cphoton/RUDE/docs/BOM.md

# BOM

For an upgrade from RUDE v1.0 to v1.1 the only hardware changes are the six ⌀5mm rods which have been replaced by just two 350 ⌀5mm steel rods and the 2x M5x40 steering bolts have been replaced by 2x M5x30.

If you come from Robak, you need HSP 102011 and 2x350 ⌀5mm steel rods and additional SHCS M3 + hex-nuts and 2x M5x30 bolts + square nuts.

This car can handle more power than Robak and is also heavier, I don't advise anything below 3S.
However be careful with 4S and higher since the HSP differentials were not designed with such powerful cars in mind. A precisely printed diffcase with a quality diff from the supplier I recommend below are key. Buy spares.

## Filament

98A / 60+D TPU from anywhere. Azurefilm 98A TPU is good. On Amazon there is 64D TPU from kexcelled alternatively there is 72D TPU from extrudr.
Not very useful for RUDE, but I use this super cheap quality filament for everything else (gridfinity etc.): https://s.click.aliexpress.com/e/_olmRVrv

## Electronics

Part | Name | QTY | Notes
--- | --- | --- | ---
ESC + motor | 36xx or 42xx up to 82mm length | 1 | F.e. 3660 = 36mm diameter & 60mm length, 4278 = 42mm diameter & 78mm length.
ESC + motor | Hobbywing Ezrun MAX10 3665SD G3 2400KV + G2 140A ESC | 1 | Recommended. The newest Ezrun MAX10 sensored series is great. Get your Hobbywing electronics at a local shop, because aliexpress doesn't do warranty!
Battery for 4S combo [max 139mm x 47mm] hardcase preferred | 3S/4S 6200mAh | 1 | 3S: https://s.click.aliexpress.com/e/_EJYJMRf 4S: https://s.click.aliexpress.com/e/_oDYiMl3 or 9400mAh big battery: https://s.click.aliexpress.com/e/_mN7RnQx
Lipo charger | | 1 | https://s.click.aliexpress.com/e/_oCQhBod
RX + TX | DumboRC DDF-350 | X10FG or X6DCG | screen, lights/indicators support and with gyro https://s.click.aliexpress.com/e/_oCQUDqW (select M2 for metal steering wheel)
Servo | DS3240-180 or any other 180 deg variant | 1 | https://s.click.aliexpress.com/e/_DnBFawT
1:8 Motor | Ysido 4274 | 1 | Cheap but overpowered https://s.click.aliexpress.com/e/_DmBblkx NOTE: you need a 1:8 ESC for this. [has 6.5mm banana plugs instead of 4mm]
1:8 ESC | Hobbywing Quicrun 8BL150 | 1 | I use this in combination with the Ysido. Get your Hobbywing electronics at a local shop, because aliexpress doesn't do warranty!

NOTE: 1:8 motors are at least twice as powerful as 1:10 motors and too much for RUDE which is a 1:10 truggy. One user tried the Ezrun MAX8 Sensored series and it kept somersaulting with just 4S with acceleration and throttle limited. Too much power causes the metal HSP parts to fail. I personally use the Ysido 2200 kV on 4S without issues, but make sure to limit throttle on tranmsitter and acceleration in ESC (this also goes for 1:10 MAX10).

## HSP

Part | Name | QTY | Notes
--- | --- | --- | ---
steering links | HSP 102011 | 2 | different from stock Robak
differential | HSP 02024 |2 | https://aliexpress.com/item/1178316591.html I recommend to get all your HSP parts from this store. Their quality seems to be superior. You can order, cancel payment, then ask seller to reduce the shipping costs.
front gear | HSP 02030 |1 |
rear gear | HSP 03015 |1 |e-clip shoud be included
cvd | HSP 108015 |4 |2 types available; more info on robaki.dev
5/6/7mm wheel hex | HSP 122042 |4 | https://s.click.aliexpress.com/e/_DnSrrOX depth depends a bit on the type of wheel. For the recommended wheels 5/6mm.
cups | HSP 02016 |2 |
servo link | HSP 02012 |1 |
steering links | HSP 08042 |1 |one pair (06016 also fits)
drive shaft | HSP 04003 |1 |
spur gear | HSP 11184 |1 |
pinion gear | HSP 11184 |1 | 21-29T ⌀3.175/5mm, check shaft of your motor. For weaker motors pick 21T.
ball head screw | HSP 02038 |4 |for steering
small bearings |5x10x4mm | 9pcs | https://s.click.aliexpress.com/e/_oC5hRkd / https://s.click.aliexpress.com/e/_opMIPU9 SMR105RS (ceramic!)
big bearings |10x15x4mm | 12pcs | https://s.click.aliexpress.com/e/_oFJ5Pg9

### HSP must-have spares

Part | Name | QTY | Notes
--- | --- | --- | ---
differential | HSP 02024 | 2 |
front gear | HSP 02030 |1 |
rear gear | HSP 03015 |1 |e-clip shoud be included
cups | HSP 02016 |1 |
cvd | HSP 108015 |2 |
drive shaft | HSP 04003 |1 |
pinion gear | HSP 11184 |1 |⌀3.175/5mm, check shaft of your motor
grub screws | HSP 02099 |1 |
main gear pin | HSP 08027 |1 |
small bearings |5x10x4mm | 4 | 
big bearings |10x15x4mm | 4 | 
diff cups | HSP 02032 | 4 |

## Other

Part | Name | QTY | Notes
--- | --- | --- | ---
wheels | HSP 88005 | 4 | I recommend cheap plastic rims https://aliexpress.com/item/4000537437419.html . They break but are cheap to replace. There's also metal ones https://aliexpress.com/item/4000537479774.html they don't break but will transfer impacts to CVDs which then wobble, hence I recommend the 'weak' plastic rims. The previous ones need to be glued manually. Preglued (much better) options: Traxxas wheels TRX6792. Alternatively very cheap set from YSIDO: https://s.click.aliexpress.com/e/_oF5A4wt the wheels are very narrow and the steering angle is very small, to compensate take 7mm wheel hex for front wheels ( https://s.click.aliexpress.com/e/_DnSrrOX ).
shocks |INJORA Aluminum Shock Absorber 100mm | 4 | https://s.click.aliexpress.com/e/_EQmCy8T comes with two springs per shock, use them both, intertwined
battery straps |20mm width; 200mm long |2 |max width 25mm
Steel shafts |⌀5mm steel rod | 2x350mm | https://s.click.aliexpress.com/e/_ooYsAH1 (v1.0 needed 2x190mm + 4x66mm ⌀5mm steel rods)
silicone oil (front & rear shocks) | 2000 cSt | 20ml | this car's mass is >3kg so heavier oils preferred https://s.click.aliexpress.com/e/_ooUaPnU (very cheap)
silicone oil (diffs) |80.000 cSt | 20ml |50.000-100.000 cSt will work https://s.click.aliexpress.com/e/_mKMass6 (from local shop is likely cheaper)
thread-locking fluid | | 10ml | Medium strength blue (cheap option: https://s.click.aliexpress.com/e/_mtYoqXC )
lithium grease | | 50ml |or any other grease for gears
CA glue / ZAP-RT | power glue | 20ml |tire glue (ZAP-RT for metal rims)

## Bolts

Part | Name | QTY | Notes
--- | --- | --- | ---
M5 Socket Head Screws | M5 SHCS 2x30mm | | https://s.click.aliexpress.com/e/_mNYNVTc
M5 Square Nuts  | | 2 | https://s.click.aliexpress.com/e/_mKvxiiA
M3 Socket Head Screws | M3 SHCS 4x30 4x20 4x16 4x12 1x6mm | | https://s.click.aliexpress.com/e/_mNYNVTc
M3 Titanium SHCS | DIN912 | M3 SHCS 4x30mm | https://s.click.aliexpress.com/e/_oCheVJZ for top bolts for shock mounting titanium is recommended to prevent bends
M3 Flat Head Screws | M3 FHCS 30/25/20/16/12mm |20pcs each | https://s.click.aliexpress.com/e/_ontwkaW
M3 Thin Square Nuts  |DIN 562 |50 |ht. 1.8mm https://s.click.aliexpress.com/e/_mKvxiiA
M3 Nylon-Insert Locknuts |DIN 985; ISO 10511 |12 | for arm hinges https://s.click.aliexpress.com/e/_mKRqmKW
M3 General Purpose Washers |DIN 125; ISO 7089 |3 |motor mount to the plate https://s.click.aliexpress.com/e/_ooqqPiE
M4 Nylon-Insert Locknuts |DIN 985; ISO 10511 |4 |for wheels https://s.click.aliexpress.com/e/_mKRqmKW
M4 General Purpose Washers |DIN 125; ISO 7089 |4 |for wheels https://s.click.aliexpress.com/e/_ooqqPiE

## For stock body

Part | Name | QTY | Notes
--- | --- | --- | ---
M2x10mm Socket Head Screws |DIN 912; ISO 4762 |10 |bolt 2 body parts together https://s.click.aliexpress.com/e/_mKoi8nC 
M2 Nylon-Insert Locknuts |DIN 985; ISO 10511 |10 |bolt 2 body parts together https://s.click.aliexpress.com/e/_mKRqmKW
M8x60 bolt full thread |  |1 | Full Thread! To bolt rear body part to car. https://s.click.aliexpress.com/e/_EJMfISf 
M8 flange lock nut |  |1 | https://s.click.aliexpress.com/e/_Ew4tm55
M8 wing nut |  |1 | https://s.click.aliexpress.com/e/_EwzpS4j

## Tools

Part | Name | QTY | Notes
--- | --- | --- | ---
Worx electric screwdriver | WX242 | 1 | https://aliexpress.com/item/1005006025572712.html 
Allen bits | H2 | 2 | https://s.click.aliexpress.com/e/_EuJdN3h
Lipo checker | | 1 | https://s.click.aliexpress.com/e/_opcYMvr
