cphoton/RUDE/STEP/EXPERIMENTAL/Center Diffs/diy/CenterDiffPlate.step

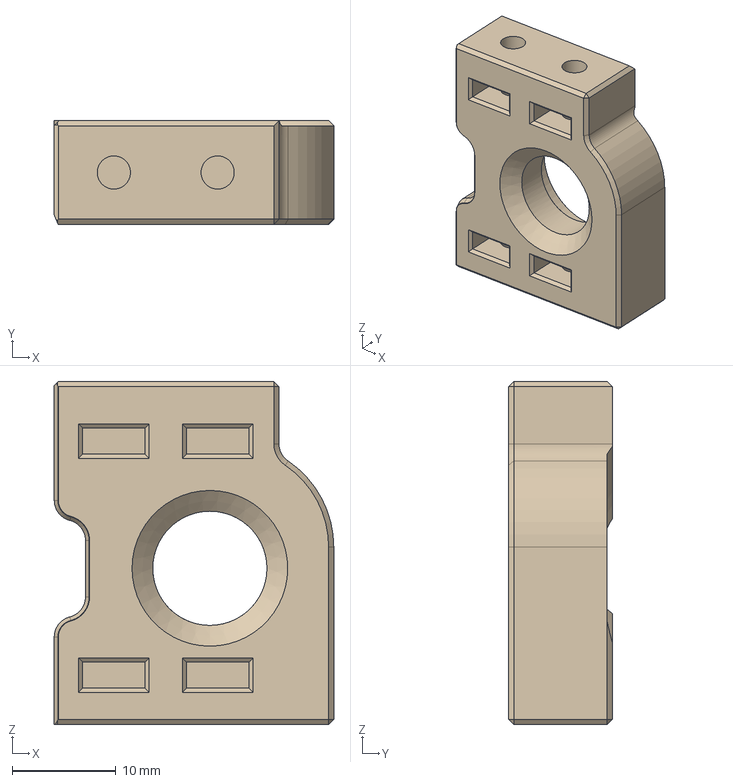
[picture p1: CAD file, 2025-06-04]
STEP/EXPERIMENTAL/Center Diffs/diy/CenterDiffPlate.step
26.9 x 10.0 x 33.1 mm
