cphoton/RUDE/STEP/EXPERIMENTAL/Center Diffs/non-diy/MotorPlate_ysido.step

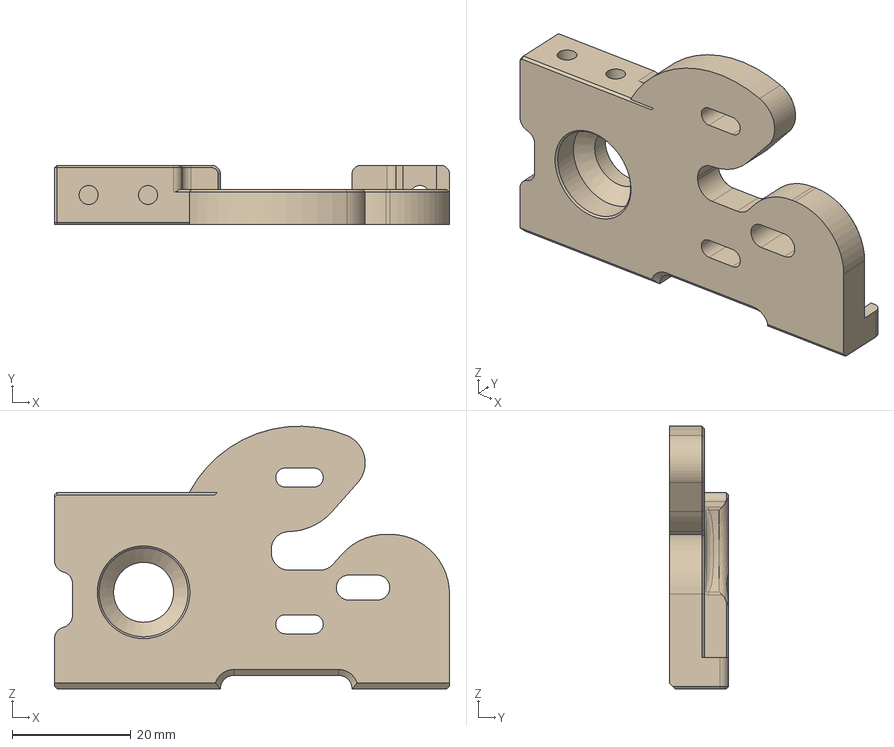
[picture p2: CAD file, 2025-06-04]
STEP/EXPERIMENTAL/Center Diffs/non-diy/MotorPlate_ysido.step
66.5 x 10.0 x 44.2 mm
