cphoton/RUDE/STEP/EXPERIMENTAL/Chassis.step

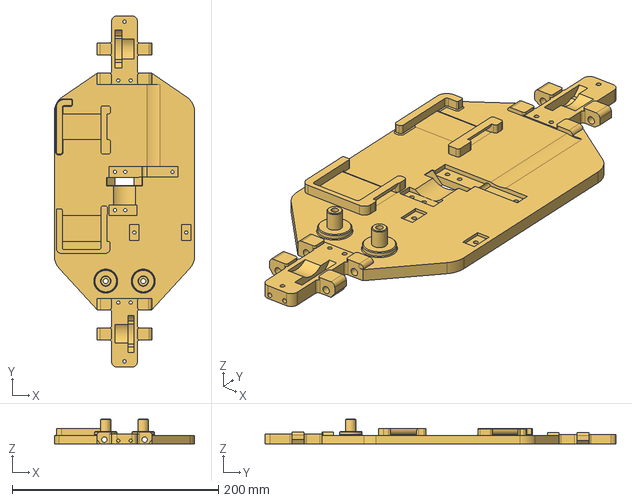
[picture p3: CAD file, 2025-06-04]
STEP/EXPERIMENTAL/Chassis.step
136.0 x 340.0 x 23.8 mm
