cphoton/RUDE/STEP/v1.1/Chassis.step

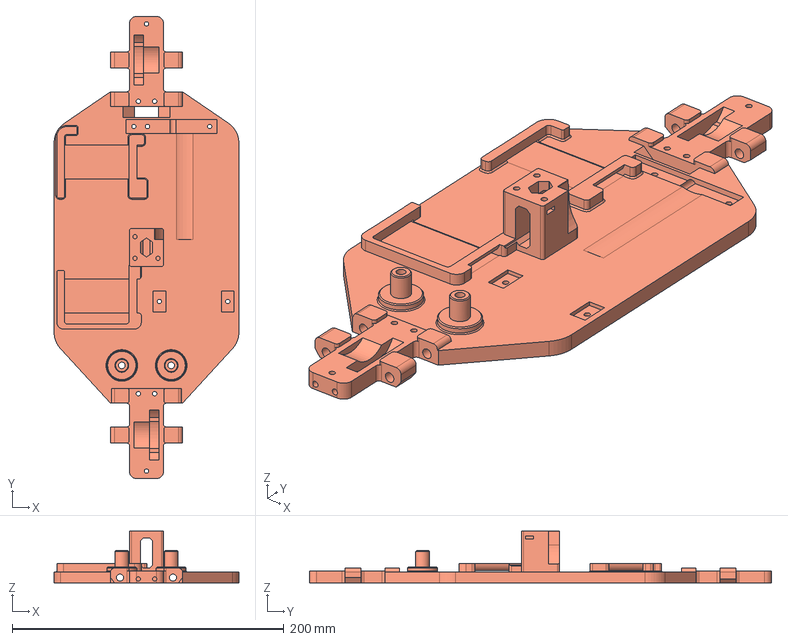
[picture p4: CAD file, 2025-08-29]
STEP/v1.1/Chassis.step
136.0 x 340.0 x 38.3 mm
