cphoton/RUDE/STEP/EXPERIMENTAL/Center Diffs/non-diy/CenterDiffPlate.step

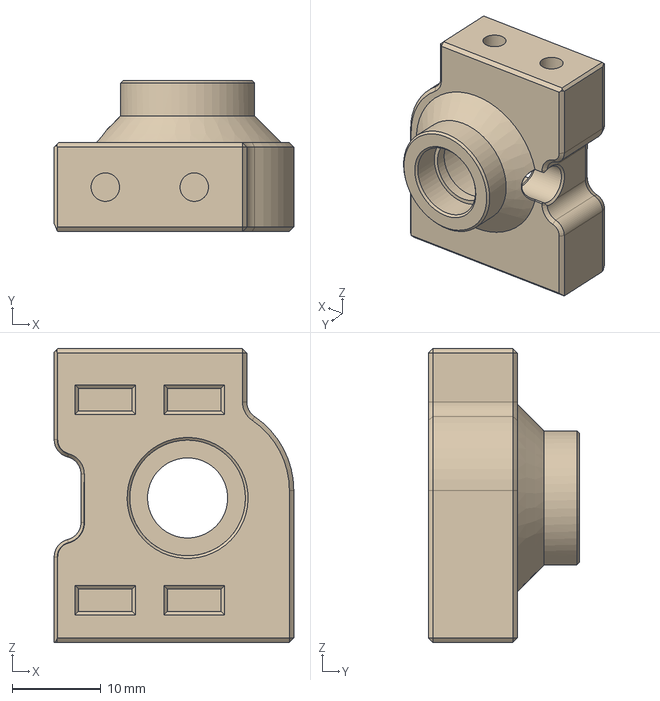
[picture p5: CAD file, 2025-06-04]
STEP/EXPERIMENTAL/Center Diffs/non-diy/CenterDiffPlate.step
26.9 x 17.0 x 33.1 mm
