cphoton/RUDE/STEP/EXPERIMENTAL/TopDeck.step

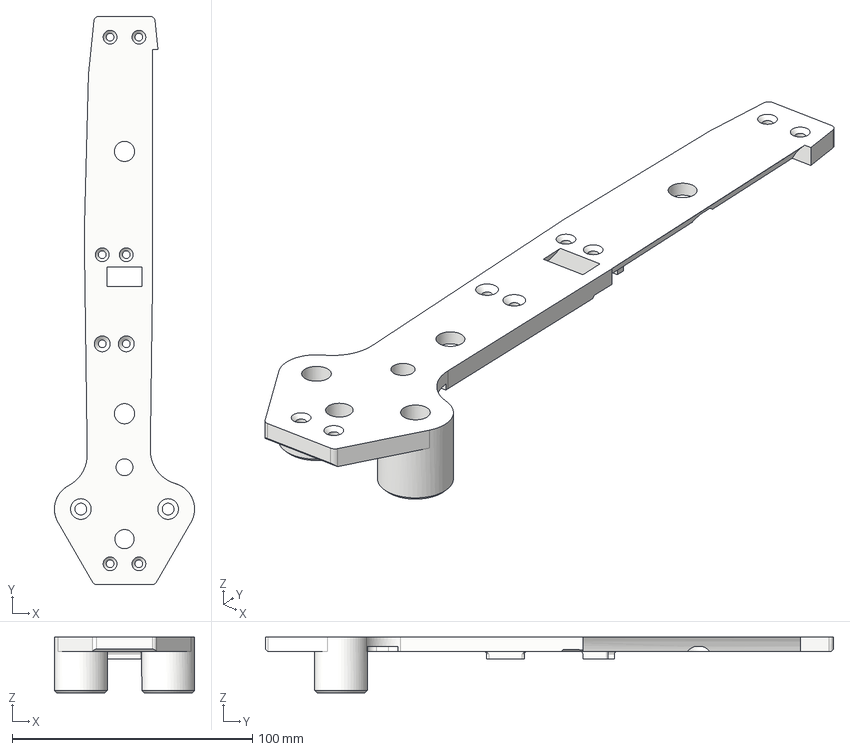
[picture p6: CAD file, 2025-06-04]
STEP/EXPERIMENTAL/TopDeck.step
58.3 x 236.4 x 23.2 mm
