cphoton/RUDE/STEP/EXPERIMENTAL/ServoMount_Quicrun8BL150.step

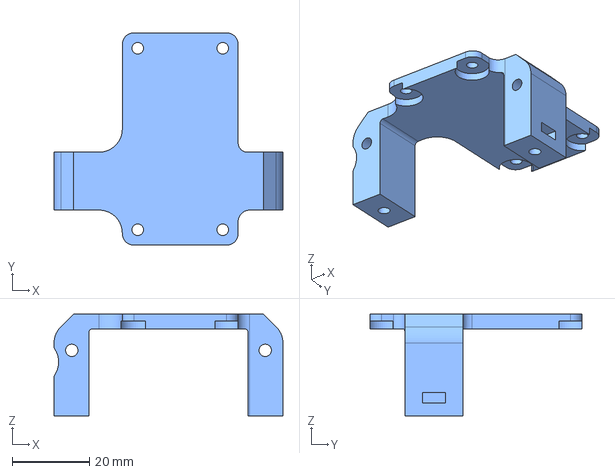
[picture p7: CAD file, 2025-06-04]
STEP/EXPERIMENTAL/ServoMount_Quicrun8BL150.step
59.3 x 55.0 x 26.3 mm
