cphoton/RUDE/STEP/EXPERIMENTAL/Center Diffs/diy/Spur Gear Mount.step

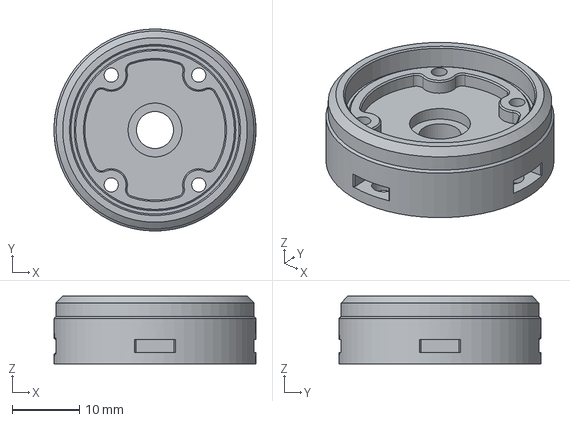
[picture p8: CAD file, 2025-06-04]
STEP/EXPERIMENTAL/Center Diffs/diy/Spur Gear Mount.step
30.0 x 30.0 x 10.1 mm
