cphoton/RUDE/STEP/EXPERIMENTAL/Center Diffs/diy/MotorPlate_MAX10.step

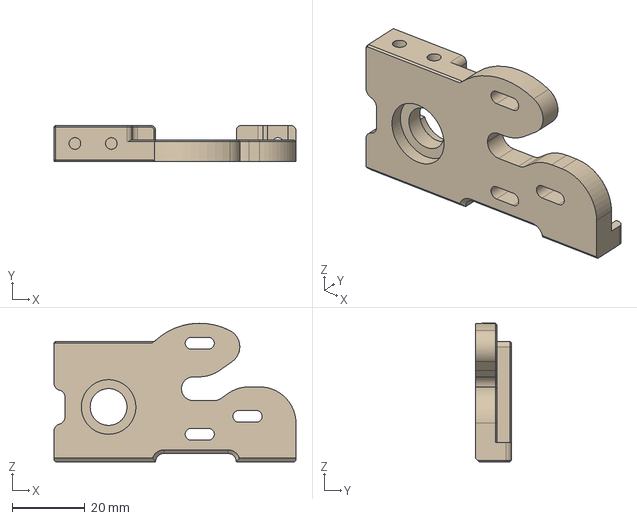
[picture p9: CAD file, 2025-06-04]
STEP/EXPERIMENTAL/Center Diffs/diy/MotorPlate_MAX10.step
66.5 x 10.0 x 38.1 mm
