cphoton/RUDE/(list of files, cad)

Other CAD files:
STEP/EXPERIMENTAL/Center Diffs/diy/CenterDiffPlate No Diff Cup.step
STEP/EXPERIMENTAL/Center Diffs/diy/MotorPlate_ysido.step
