cphoton/RUDE/(commit log)

2025-06-04 Initial version with current parts and assembly instructions and guidance.
    [CenterDiffPlate No Diff Cup.step, CenterDiffPlate.step, Chassis.step, MotorPlate_MAX10.step, MotorPlate_ysido.step, ServoMount_Quicrun8BL150.step, Spur Gear Mount.step, TopDeck.step]
2025-06-04 Minor correction to documentation. BOM added.
2025-08-29 Chassis cleanup/fixes by ambrmart
    [Chassis.step]
